thegreatbat0110/one_bit_sram_design/Week_2_and_3/Schematics/cir_six_t.png

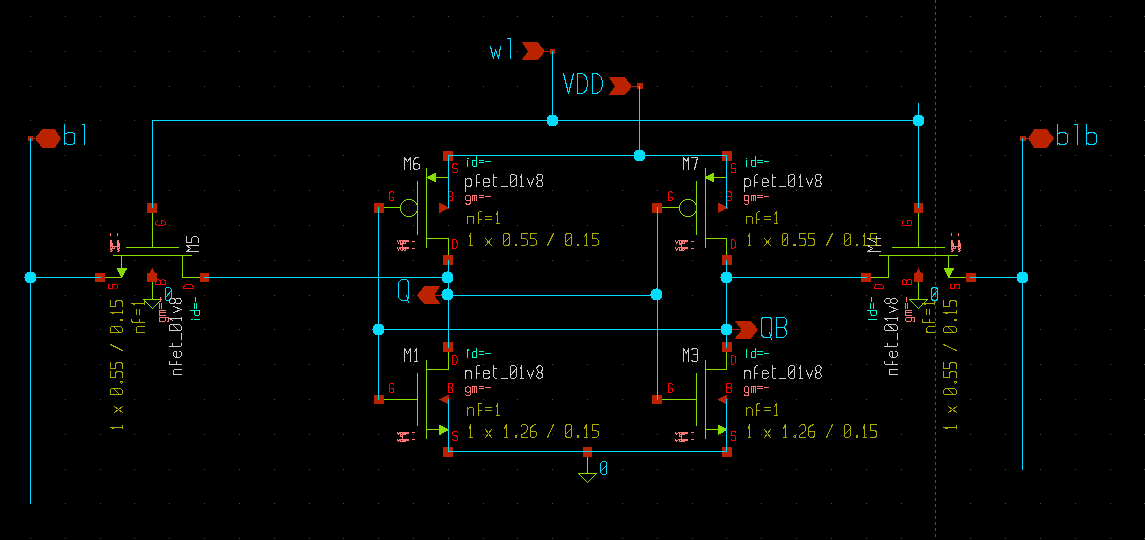
Week_2_and_3/Schematics/cir_six_t.png
