thegreatbat0110/one_bit_sram_design/Week_2_and_3/Schematics/cir_write_driver.png

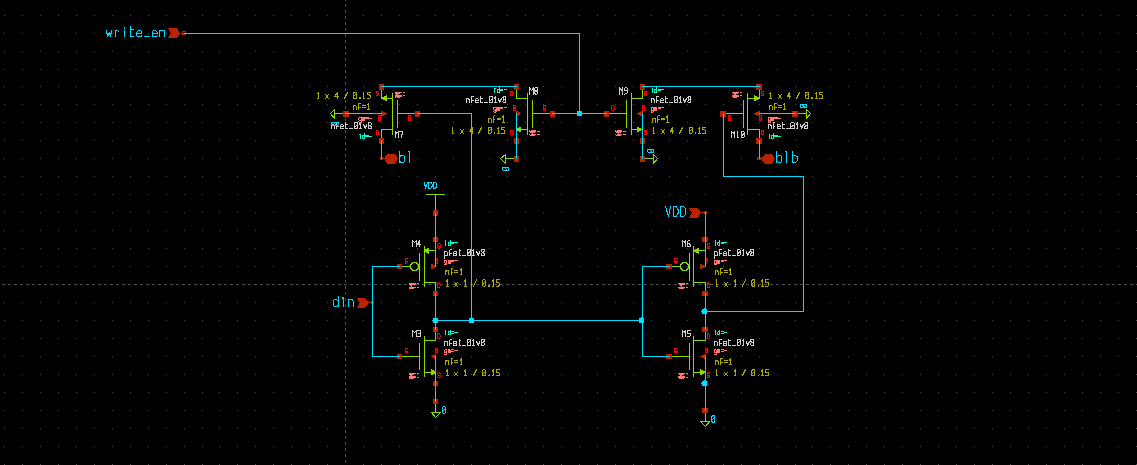
Week_2_and_3/Schematics/cir_write_driver.png
