thegreatbat0110/one_bit_sram_design/Week_2_and_3/Waveforms/wave_n_curve.png

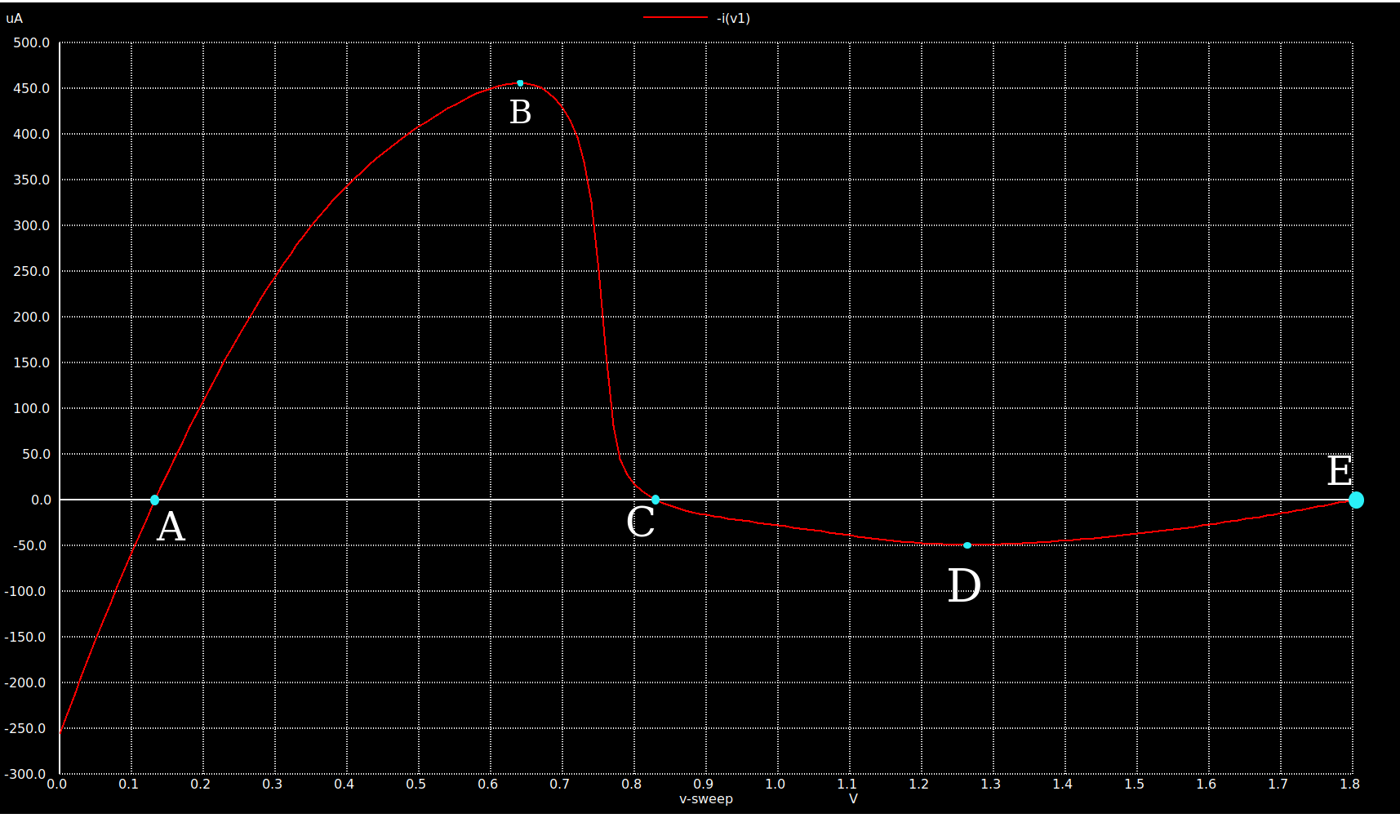
Week_2_and_3/Waveforms/wave_n_curve.png
