thegreatbat0110/one_bit_sram_design/Week_2_and_3/Waveforms/wave_one_bit_final2.png

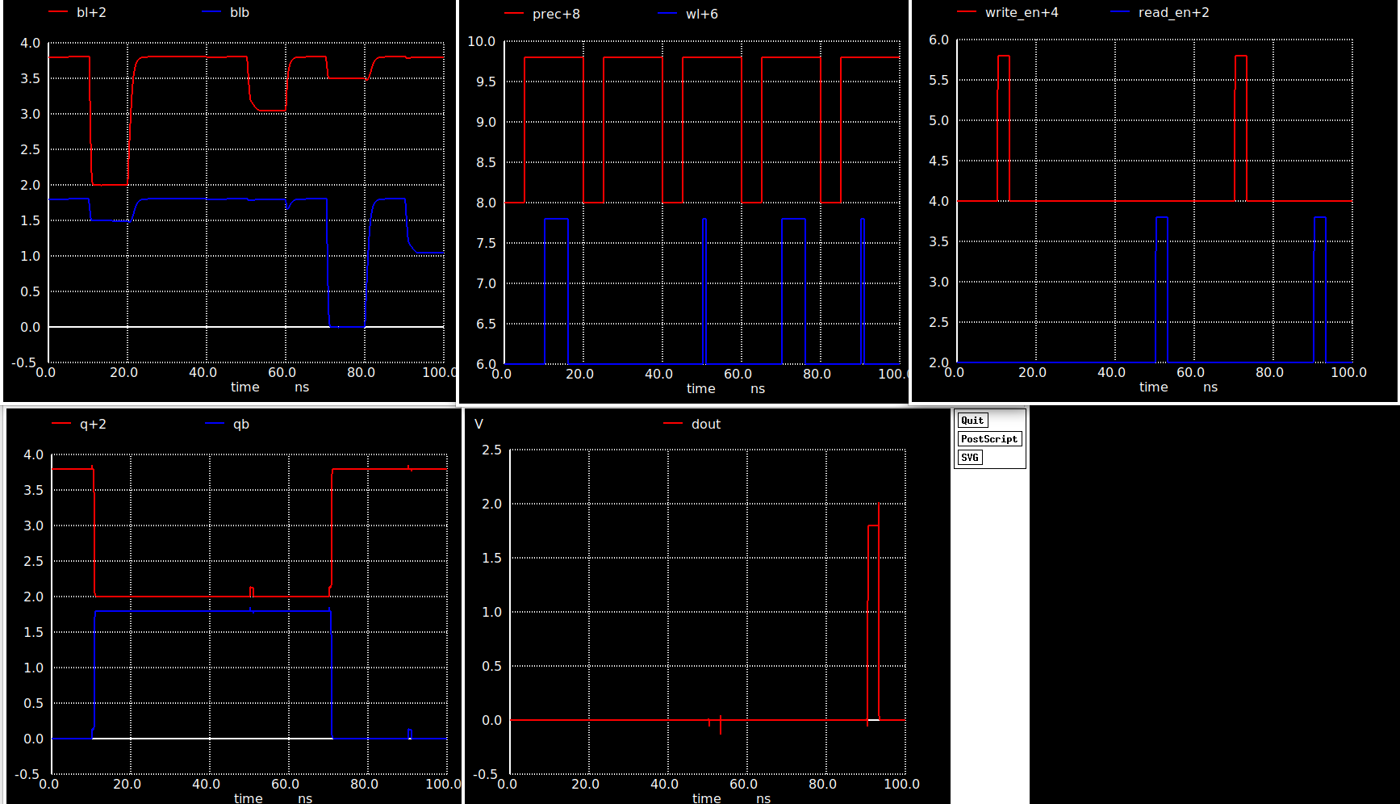
Week_2_and_3/Waveforms/wave_one_bit_final2.png
