thegreatbat0110/one_bit_sram_design/Week_2_and_3/raw_measurements.jpg

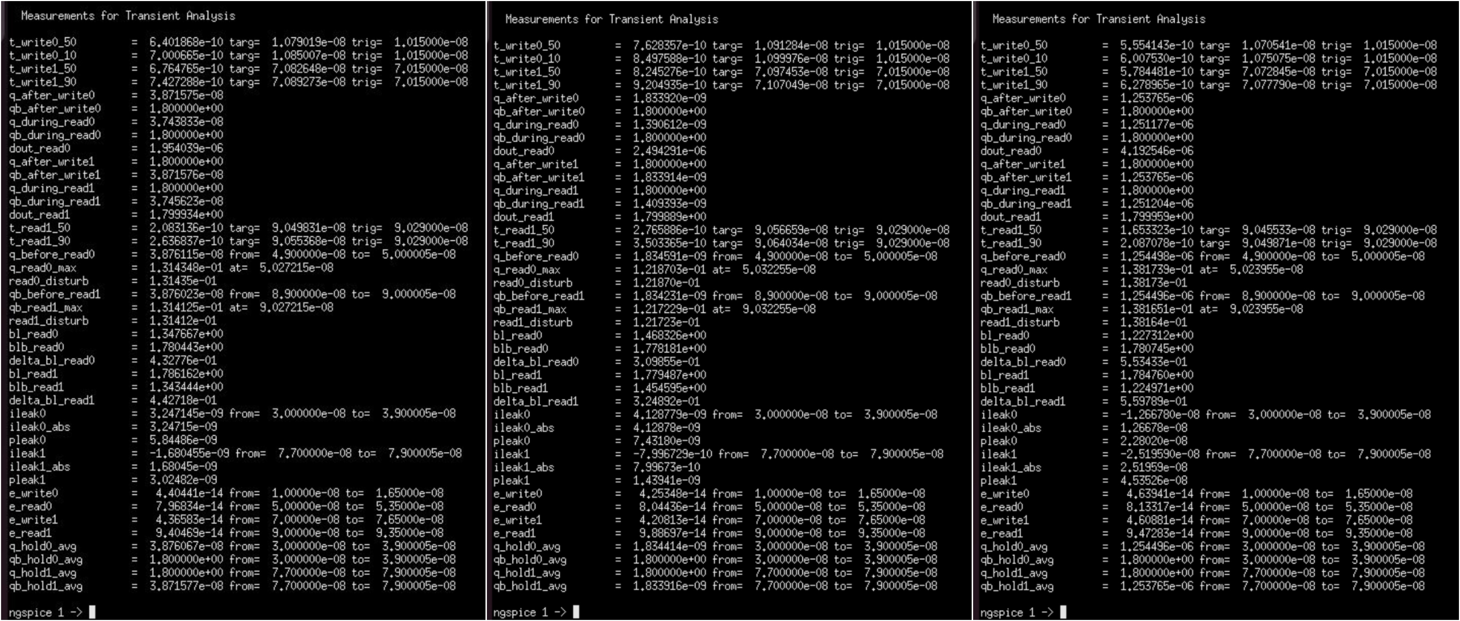
Week_2_and_3/raw_measurements.jpg
