thegreatbat0110/one_bit_sram_design/SNM/Wriite_SNM/six_t_write_snm.spice

** sch_path: /home/kaavya/chip/SRAM_SKY130/xschem/six_t_write_snm.sch
**.subckt six_t_write_snm
XM2 q2 qb2 0 0 sky130_fd_pr__nfet_01v8 L=0.15 W=1.26 nf=1 ad=0.3654 as=0.3654 pd=3.1 ps=3.1 nrd=0.23015873015873
+ nrs=0.23015873015873 sa=0 sb=0 sd=0 mult=1
XM3 q2 qb2 VDD VDD sky130_fd_pr__pfet_01v8 L=0.15 W=0.55 nf=1 ad=0.1595 as=0.1595 pd=1.68 ps=1.68 nrd=0.527272727272727
+ nrs=0.527272727272727 sa=0 sb=0 sd=0 mult=1
XM4 qb1 q1 0 0 sky130_fd_pr__nfet_01v8 L=0.15 W=1.26 nf=1 ad=0.3654 as=0.3654 pd=3.1 ps=3.1 nrd=0.23015873015873
+ nrs=0.23015873015873 sa=0 sb=0 sd=0 mult=1
XM5 qb1 q1 VDD VDD sky130_fd_pr__pfet_01v8 L=0.15 W=0.55 nf=1 ad=0.1595 as=0.1595 pd=1.68 ps=1.68 nrd=1.68 nrd=0.527272727272727
+ nrs=0.527272727272727 sa=0 sb=0 sd=0 mult=1
v1 q1 0 0
v2 qb2 0 0
XM6 bl VDD qb1 0 sky130_fd_pr__nfet_01v8 L=0.15 W=0.55 nf=1 ad=0.1595 as=0.1595 pd=1.68 ps=1.68 nrd=0.527272727272727
+ nrs=0.527272727272727 sa=0 sb=0 sd=0 mult=1
XM7 blb VDD q2 0 sky130_fd_pr__nfet_01v8 L=0.15 W=0.55 nf=1 ad=0.1595 as=0.1595 pd=1.68 ps=1.68 nrd=0.527272727272727
+ nrs=0.527272727272727 sa=0 sb=0 sd=0 mult=1
**** begin user architecture code

.lib /home/kaavya/.ciel/ciel/sky130/versions/9233c19260cd813c3fa67dd4594fe4cc67016832/sky130A/libs.tech/ngspice/sky130.lib.spice __CORNER__
.option temp = __TEMP__

VDD VDD 0 1.8
Vbl bl 0 0
Vblb blb 0 1.8

.control
run
dc V1 0 1.8 0.01
wrdata sim_results_wsnm/dc1___CORNER___t__TEMP__.txt v(q1) v(qb1)
dc V2 0 1.8 0.01
wrdata sim_results_wsnm/dc2___CORNER___t__TEMP__.txt v(q2) v(qb2)
.endc

**** end user architecture code
**.ends
.GLOBAL VDD
.GLOBAL blb
.GLOBAL bl
.end
