thegreatbat0110/one_bit_sram_design/SNM/Read_SNM/six_t_read_snm.spice

** sch_path: /home/kaavya/chip/SRAM_SKY130/xschem/six_t_read_snm.sch
**.subckt six_t_read_snm
XM2 Q1 Qb1 0 0 sky130_fd_pr__nfet_01v8 L=0.15 W=1.26 nf=1 ad='int((nf+1)/2) * W/nf * 0.29' as='int((nf+2)/2) * W/nf * 0.29' pd='2*int((nf+1)/2) * (W/nf + 0.29)'
+ ps='2*int((nf+2)/2) * (W/nf + 0.29)' nrd='0.29 / W' nrs='0.29 / W' sa=0 sb=0 sd=0 mult=1
XM3 Qb2 Q2 0 0 sky130_fd_pr__nfet_01v8 L=0.15 W=1.26 nf=1 ad='int((nf+1)/2) * W/nf * 0.29' as='int((nf+2)/2) * W/nf * 0.29' pd='2*int((nf+1)/2) * (W/nf + 0.29)'
+ ps='2*int((nf+2)/2) * (W/nf + 0.29)' nrd='0.29 / W' nrs='0.29 / W' sa=0 sb=0 sd=0 mult=1
XM4 VDD VDD Qb2 0 sky130_fd_pr__nfet_01v8 L=0.15 W=0.55 nf=1 ad='int((nf+1)/2) * W/nf * 0.29' as='int((nf+2)/2) * W/nf * 0.29' pd='2*int((nf+1)/2) * (W/nf + 0.29)'
+ ps='2*int((nf+2)/2) * (W/nf + 0.29)' nrd='0.29 / W' nrs='0.29 / W' sa=0 sb=0 sd=0 mult=1
XM5 Q1 VDD VDD 0 sky130_fd_pr__nfet_01v8 L=0.15 W=0.55 nf=1 ad='int((nf+1)/2) * W/nf * 0.29' as='int((nf+2)/2) * W/nf * 0.29' pd='2*int((nf+1)/2) * (W/nf + 0.29)'
+ ps='2*int((nf+2)/2) * (W/nf + 0.29)' nrd='0.29 / W' nrs='0.29 / W' sa=0 sb=0 sd=0 mult=1
XM6 Q1 Qb1 VDD VDD sky130_fd_pr__pfet_01v8 L=0.15 W=0.55 nf=1 ad='int((nf+1)/2) * W/nf * 0.29' as='int((nf+2)/2) * W/nf * 0.29' pd='2*int((nf+1)/2) * (W/nf + 0.29)'
+ ps='2*int((nf+2)/2) * (W/nf + 0.29)' nrd='0.29 / W' nrs='0.29 / W' sa=0 sb=0 sd=0 mult=1
XM7 Qb2 Q2 VDD VDD sky130_fd_pr__pfet_01v8 L=0.15 W=0.55 nf=1 ad='int((nf+1)/2) * W/nf * 0.29' as='int((nf+2)/2) * W/nf * 0.29' pd='2*int((nf+1)/2) * (W/nf + 0.29)'
+ ps='2*int((nf+2)/2) * (W/nf + 0.29)' nrd='0.29 / W' nrs='0.29 / W' sa=0 sb=0 sd=0 mult=1
V1 Qb1 0 1.8
V2 Q2 0 1.8
**** begin user architecture code

.lib /home/kaavya/.ciel/ciel/sky130/versions/9233c19260cd813c3fa67dd4594fe4cc67016832/sky130A/libs.tech/ngspice/sky130.lib.spice __CORNER__
.option temp = __TEMP__

vdd vdd 0 1.8
.ic v(Q1)=0 v(Qb1)=1.8 v(Q2)=1.8 v(Qb2)=0

.control
run
dc V1 0 1.8 0.01
wrdata sim_results/dc1___CORNER___t__TEMP__.txt v(Q1) v(Qb1)
dc V2 0 1.8 0.01
wrdata sim_results/dc2___CORNER___t__TEMP__.txt v(Q2) v(Qb2)
.endc


*remove plot (in .control for using batch mode in ngspice)
*plot dc1.v(Qb1) vs dc1.v(Q1) dc2.v(Qb2) vs dc2.v(Q2)




**** end user architecture code
**.ends
.GLOBAL VDD
.end
